Bardreamaster/SuperCapacitor/SuperCapacitor2/References/BOOT配置.png

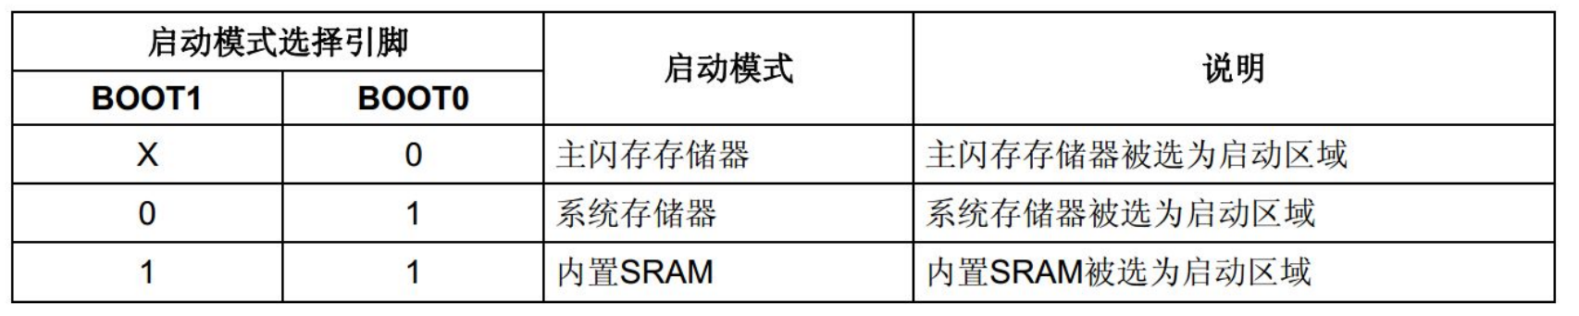
SuperCapacitor2/References/BOOT配置.png
