Bardreamaster/SuperCapacitor/SuperCapacitor2/References/螺丝尺寸.png

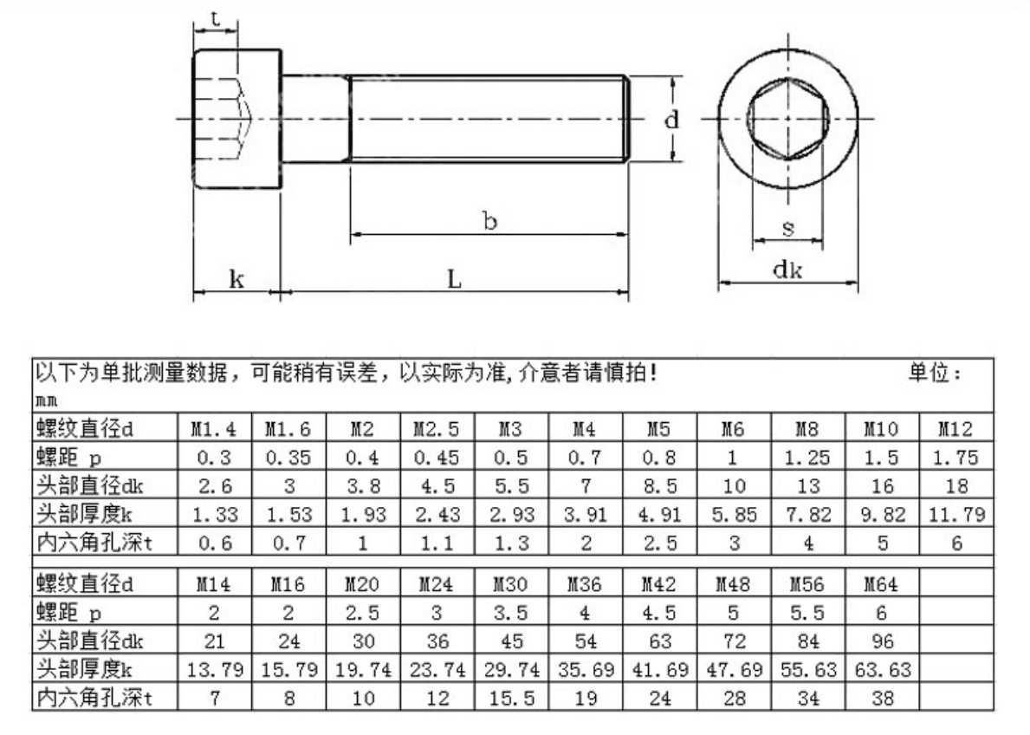
SuperCapacitor2/References/螺丝尺寸.png
