Bardreamaster/SuperCapacitor/SuperCapacitor2/Schematic/CapacitorModule/Capacitor1.0B2.bmp

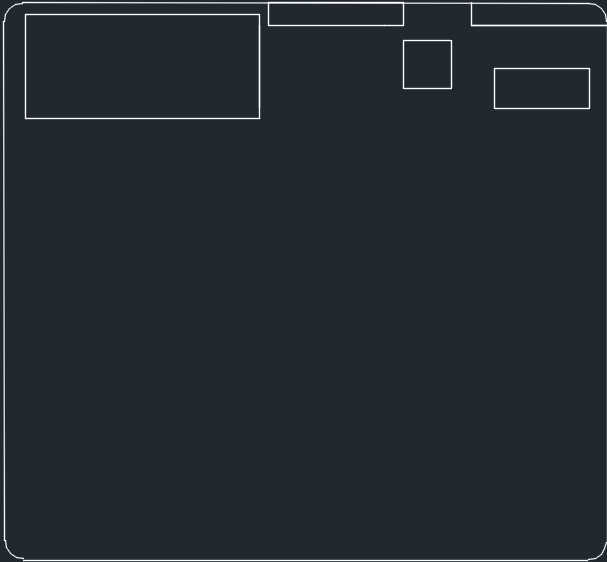
SuperCapacitor2/Schematic/CapacitorModule/Capacitor1.0B2.bmp
