Bardreamaster/SuperCapacitor/SuperCapacitor2/Schematic/CapacitorModule/Capacitor1.0T1.bmp

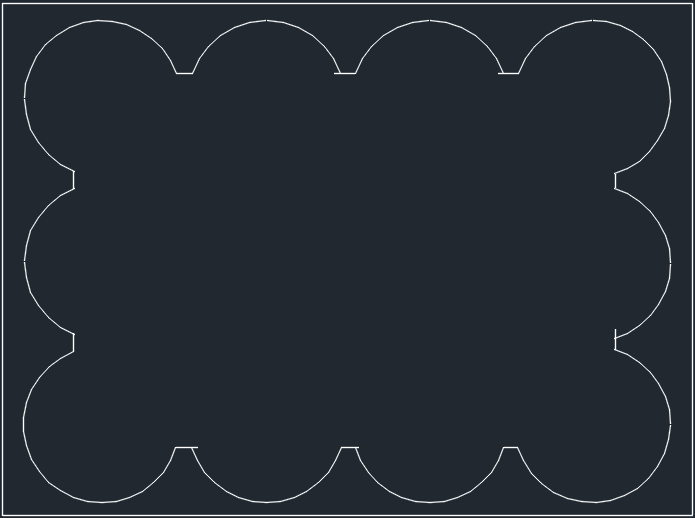
SuperCapacitor2/Schematic/CapacitorModule/Capacitor1.0T1.bmp
