Bardreamaster/SuperCapacitor/SuperCapacitor2/Schematic/EasyEDA_SuperCapacitor2.0_2020-03-19_00-03-40/BOM_Capacitor_2020-05-15_22-47-46.csv

ID | Name | Designator | Footprint | Quantity | Manufacturer Part | Manufacturer | Supplier | Supplier Part | LCSC Assembly
1 | 120uF | C15 | CAP-TH_BD18.0-P7.50-D1.2-FD | 1 | 120uF 450V 18*40 | ValuePro | LCSC | C47856
2 | 2SD1804L-T-TN3-R | Q12,Q11,Q8,Q5,Q2,Q1,Q9,Q4,Q6,Q3,Q10,Q7 | TO-252-2_L6.5-W6.1-P4.58-LS10.0-BR | 12 | 2SD1804L-T-TN3-R | UTC | LCSC | C85224 | Yes
3 | K8-5851E-L1 | SW1 | SW-TH_6P-L5.8-W5.8-P2.00-LS4.5-BL | 1 | K8-5851E-L1 | HRO | LCSC | C111760
4 | ORH-G36G | LED1,LED2,LED3,LED4 | LED0603-R-RD | 4 | ORH-G36G | Orient | LCSC | C205443 | Yes
5 | 82 | C4,C6,C1,C8,C11,C7,C10,C2,C5,C12,C9,C3 | CAP-TH_BD22.0-P10.00-D2.3-FD | 12 | VEC3R0107QG | VINATech | LCSC | C132806
6 | 4.7 | R22,R27,R12,R26,R1,R8,R21,R28,R35,R18,R3,R36,R29,R31,R4,R10,R20,R19,R2,R17,R11,R13,R9,R30 | 0603 | 24 | CR0603FA11R0G | LIZ Elec | LCSC | C100733
7 | 1.3K | R44,R43,R41,R39 | R0402 | 4 | 0402WGF1301TCE | UniOhm | LCSC | C25866 | Yes
8 | 1K | R37,R40,R42,R45,R46,R47 | R0402 | 6 | 0402WGF1001TCE | UniOhm | LCSC | C11702 | Yes
9 | 1K | R16,R7,R23,R6,R33,R14,R15,R34,R5,R25,R24,R32 | 0603 | 12 | RC0603DR-071KL | YAGEO | LCSC | C100050
10 | 1uF | C14,C13 | C0603 | 2 | CL10A105KB8NNNC | SAMSUNG | LCSC | C15849 | Yes
11 | LMSZ5233BT1G | D1 | SOD-123_L2.7-W1.6-LS3.7-RD | 1 | LMSZ5233BT1G | LRC | LCSC | C115277 | Yes
12 | XT60 | XT1 | XT60 BY BUCK | 1 | XT60
13 | HT7027A-1 | U8,U12,U6,U5,U1,U7,U4,U9,U2,U11,U3,U10 | SOT-89 | 12 | HT7027A-1 | HOLTEK | LCSC | C40186 | Yes
14 | LM339D | U13 | SOIC-14_L8.7-W3.9-P1.27-LS6.0-BL | 1 | LM339D | Texas Instruments | LCSC | C350549 | Yes
15 | 3.4K | R38 | R0402 | 1 | 0402WGF3401TCE | UniOhm | LCSC | C4940 | Yes
