Bardreamaster/SuperCapacitor/SuperCapacitor2/Schematic/EasyEDA_SuperCapacitor2.0_2020-03-19_00-03-40/BOM_SuperCapacitor2.0_2020-04-24_17-17-58.csv

ID | Name | Designator | Footprint | Quantity | Manufacturer Part | Manufacturer | Supplier | Supplier Part | LCSC Assembly
1 | BCX56-16,115 | Q12 | SOT-89-3_L4.5-W2.5-P1.50-LS4.2-BR | 1 | BCX56-16,115 | Nexperia | LCSC | C100026 | Yes
2 | 1N4148WS T4 | D8,D9 | SOD-323_L1.8-W1.3-LS2.5-FD | 2 | 1N4148WS T4 | CJ | LCSC | C2128 | Yes
3 | GH1.25-4P-立式贴片 | USART1 | SMD-1.25MM-4P-JST-H4.05 | 1 | BM04B-GHS-TBT(LF)(SN) | JST Sales America | LCSC | C161692
4 | 47uF | C22 | CASE-A_3216 | 1 | CA45-A010K476T | Xiangyee | LCSC | C127069 | Yes
5 | MF-NSMF050-2 | U3,U4 | FUSE-1206 | 2 | MF-NSMF050-2 | BOURNS | LCSC | C75464 | Yes
6 | BZT52C3V3S_C173439 | D5,D7,D6 | SOD-323_L1.8-W1.3-LS2.5-RD | 3 | BZT52C3V3S | (MDD) Jiangsu Yutai Elec | LCSC | C173439 | Yes
7 | 100K | R19,R21,R20 | R0402 | 3 | 0402WGF1003TCE | UniOhm | LCSC | C25741 | Yes
8 | 4.7uF | C29 | C0603 | 1 | CL10A475KO8NNNC | SAMSUNG | LCSC | C19666 | Yes
9 | 100 | R2 | R0402 | 1 | AC0402FR-07100RL | YAGEO | LCSC | C144808
10 | molexP4卧 | CN1 | SMD-10.15X4.8-4P | 1 | 532610471 | MOLEX | LCSC | C127368
11 | 33R | R9 | R0603 | 1
12 | 100k | R8 | R0603 | 1
13 | 10K | R16,R22,R23,R24,R13 | R0402 | 5 | 0402WGF1002TCE | UniOhm | LCSC | C25744 | Yes
14 | 4.7nF | C13 | C0402 | 1 | 0402B472K500NT | FH | LCSC | C1538 | Yes
15 | 40.2K | R1 | R0603 | 1 | 0603WAF4022T5E | UniOhm | LCSC | C12447 | Yes
16 | 220uF | C57,C38,C56,C37 | CAP-SMD_BD10.0-L10.3-W10.3-FD | 4 | DV221M050G105A | CapXon | LCSC | C65217
17 | 10uH | L2,L3 | L0603 | 2 | SDFL2012S100KTF | Sunlord | LCSC | C1046 | Yes
18 | 33pF | C24,C25 | C0603 | 2 | CL05C330JB5NNNC | SAMSUNG | LCSC | C70465
19 | 68K | R6,R7 | R0603 | 2 | 0603WAF6802T5E | UniOhm | LCSC | C23231 | Yes
20 | SC8701QDER | U7,U8 | QFN-32_L4.0-W4.0-P0.4-BL-EP2.6 | 2 | SC8701QDER | Southchip Semicon | LCSC | C252410 | Yes
21 | PSMN1R5-30YLC,115 | Q1 | SOT-669_L4.9-W4.0-P1.27-LS6.0-BR | 1 | PSMN1R5-30YLC,115 | Nexperia | LCSC | C427523
22 | 2.2uH | L4,L5 | IND-SMD_L17.5-W17.0_YXMAC1770 | 2 | YXMAC1770-2R2M-IGP | YUXIN TECH | LCSC | C241452
23 | 100pF | C7 | C0603 | 1 | CGA3E2C0G1H101JT0Y0N | TDK | LCSC | C76709
24 | LP5907MFX-2.5/NOPB | U2 | SOT-23-5_L3.0-W1.7-P0.95-LS2.8-BL | 1 | LP5907MFX-2.5/NOPB | TI | LCSC | C165132 | Yes
25 | SMAJ26CA-13-F | D3 | SMA_L4.4-W2.6-LS5.0-BI | 1 | SMAJ26CA-13-F | DIODES | LCSC | C134976 | Yes
26 | 8MHz | X1 | SMD-5032_2P | 1 | X50328MSD2GC | Yangxing Tech | LCSC | C172361 | Yes
27 | 10nf | C14 | C0603 | 1
28 | 1u | C48,C68,C70,C69,C49,C66 | C0402 | 6
29 | 100nf | C50,C46 | C0402 | 2
30 | 100nf | C36,C35,C34 | C0603 | 3
31 | 47pf | C52,C47 | C0402 | 2 |  |  |  | C1567
32 | 1uf | C51,C71 | C0402 | 2
33 | 47nf | C55,C75 | C0402 | 2
34 | 47pf | C72,C67 | C0402 | 2
35 | 2.2nf | C54,C73 | C0402 | 2
36 | 10nf | C53,C74 | C0402 | 2
37 | 1K | R11,R18 | R0603 | 2 | 0402WGF1001TCE | UniOhm | LCSC | C11702 | Yes
38 | BZX584C9V1 | D4 | SOD-523F_L1.7-W0.9-LS1.7-RD | 1 |  |  | LCSC |  | Yes
39 | LEDB | LEDB1 | LED-0603 | 1 |  | EVERLIGHT | LCSC | C72041 | Yes
40 | LED3V3 | LEDG1 | LED-0603 | 1 | 19-217/GHC-YR1S2/3T | EVERLIGHT | LCSC | C72043 | Yes
41 | 6.04K | RILIM4 | R0402 | 1 | WR04X6041FTL | WTC | LCSC | C168240
42 | BZT52C5V1_C173407 | D1 | SOD-123_L2.7-W1.6-LS3.7-RD | 1 | BZT52C5V1 | (MDD) Jiangsu Yutai Elec | LCSC | C173407 | Yes
43 | SVM860VB_R2_00001 | D2 | TO-277B_3P-L6.1-W4.3-LS7.0-BR | 1 | SVM860VB_R2_00001 | PANJIT International | LCSC | C391734
44 | TJA1051T/3/1J | U6 | SOIC-8_150MIL | 1 | TJA1051T/3/1J | NXP | LCSC | C38695 | Yes
45 | GH1.25-2P-立式贴片 | CAN1 | SMD-1.25MM-2P-JST-H4.05 | 1 | BM02B-GHS-TBT (LF)(SN) | JST Sales America | LCSC | C161690
46 | 100nF | C2 | C0603 | 1 | AC0603KRX7R0BB104 | YAGEO | LCSC | C408909
47 | 1uF | C30 | C0603 | 1 | CL10A105KB8NNNC | SAMSUNG | LCSC | C15849 | Yes
48 | 1k | R41,R29,R31,RDOWN2,R39,RDOWN1 | R0402 | 6
49 | NC/270K/68K/0 | R32,R42 | R0402 | 2
50 | 10K | RILIM3,RILIM2 | R0402 | 2
51 | 4.99k | R45,R33 | R0402 | 2
52 | 0/68K/NC | R34,R46 | R0402 | 2
53 | 20K | RUP2 | R0402 | 1
54 | 1K | RSS2N2 | R0402 | 1 |  |  |  | C319809
55 | 0 | R25,R10,R27,R38,R36,R28,R26,R35,R37 | R0603 | 9
56 | 20.5K | RUP1 | R0402 | 1
57 | 0.01 | RSNS1,RSNS4,RSNS3,RSNS2 | R0805 | 4 |  |  |  | C236284
58 | 1k | RSS1P1,RSS2P2,RSS2N1,RSS1N2,RSS2P1,RSS1P2,RSS1N1 | R0402 | 7 |  |  |  | C319809
59 | 10uF | C59,C58,C60,C44,C45,C65,NO1,C63,C39,C40,C64,C41 | C1206 | 12 | GRM31CR61H106KA12L | MuRata | LCSC | C77092
60 | 10K | RILIM1 | R0402 | 1 |  |  | LCSC | C25744 | Yes
61 | 47pF | C12 | C0402 | 1 | 0402CG470J500NT | FH | LCSC | C1567 | Yes
62 | 22uF | C19,C18,C16,C15,C6,C4,C5,C3 | C0603 | 8 | CL10A226MQ8NRNC | SAMSUNG | LCSC | C59461 | Yes
63 | 120 | R17,R14,R15 | R0402 | 3 | 0402WGF1200TCE | UniOhm | LCSC | C25079 | Yes
64 | 100nF | C28,C21,C32,C26,C31,C27,C33,C1 | C0603 | 8 | CL05B104KO5NNNC | SAMSUNG | LCSC | C1525 | Yes
65 | 100nF | C23 | R0603 | 1 | CL05B104KO5NNNC | SAMSUNG | LCSC | C1525 | Yes
66 | 100nF | C61,C42,C62,C43 | C0603 | 4 | CL10B104JB8NNNC | SAMSUNG | LCSC | C1525 | Yes
67 | 4.7uH | L1 | IND-SMD_L6.0-W6.0 | 1 | SMNR6028-4R7MT | ShunXiang Connaught Elec | LCSC | C266428
68 | 309K | R3 | R0603 | 1 | 0603WAF3093T5E | UniOhm | LCSC | C23001 | Yes
69 | 510 | R12 | R0402 | 1 | 0402WGF5100TCE | UniOhm | LCSC | C25123 | Yes
70 | XT30UF | XT3,XT2 | CONN-TH_XT30UPB-F | 2 | XT60
71 | XT30UM | XT1 | CONN-TH_XT30UPB-F | 1 | XT60
72 | HD70N08 | Q6,Q5,Q11,Q7,Q8,Q9,Q10 | PDFN-8_L4.9-W5.8-P1.27-LS6.1-BL FOR3 | 7 | HD70N08 | HL | LCSC | C216254
73 | HD70N08 | Q4 | PDFN-8_L4.9-W5.8-P1.27-LS6.1-BL FOR3 | 1 | HD70N08 | HL | LCSC | C190849
74 | SKRPABE010 | SW2,SW1 | KEY-SMD-4P_L4.2-W3.2-H2.5 | 2 | SKRPABE010 | ALPS | LCSC | C115360
75 | 7.68K | R4 | R0402 | 1 | 0402WGF7681TCE | UniOhm | LCSC | C25919 | Yes
76 | 100nF | C17 | C0402 | 1 | GRM188R71H104KA93D | MuRata | LCSC | C77055
77 | 17.8K | R5 | R0603 | 1 | 0603WAF1782T5E | UniOhm | LCSC | C22821 | Yes
78 | TPS54540DDAR | U1 | SOIC-8_L4.9-W3.9-P1.27-LS6.0-BL-EP | 1 | TPS54540DDAR | TI | LCSC | C95286 | Yes
79 | 4.7uF | C11,C10,C9,C8 | C0805 | 4 | CL21A475KBQNNNE | SAMSUNG | LCSC | C98192
80 | A2008WV-S-2P | CN4 | CONN-SMD_A2008WV-S-2P | 1 | A2008WV-S-2P | Changjiang Connectors | LCSC | C273123
81 | STM32F103C8T6 | U5 | LQFP-48_7X7X05P | 1 | STM32F103C8T6 | ST | LCSC | C8734
