Bardreamaster/SuperCapacitor/SuperCapacitor2/Schematic/3DModel/SCapacitor2.0.SLDPRT

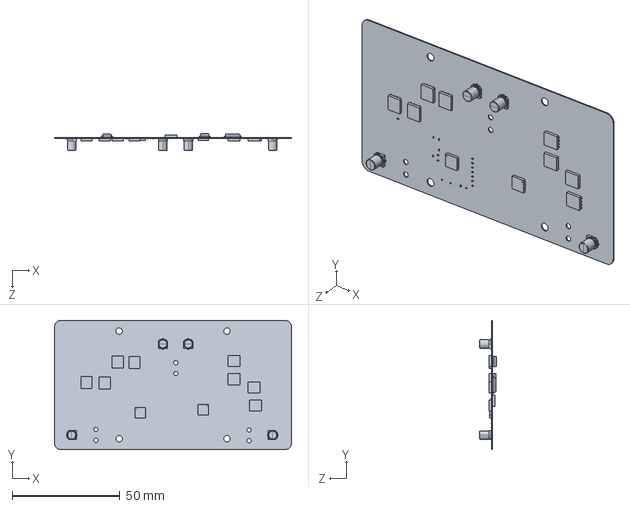
[picture p11: CAD file, 2021-09-17]
SuperCapacitor2/Schematic/3DModel/SCapacitor2.0.SLDPRT
110.0 x 60.0 x 7.66 mm
