Bardreamaster/SuperCapacitor/SuperCapacitor2/Schematic/CapacitorModule/Capacitor1.0_2020-07-27_20-29-36.dxf

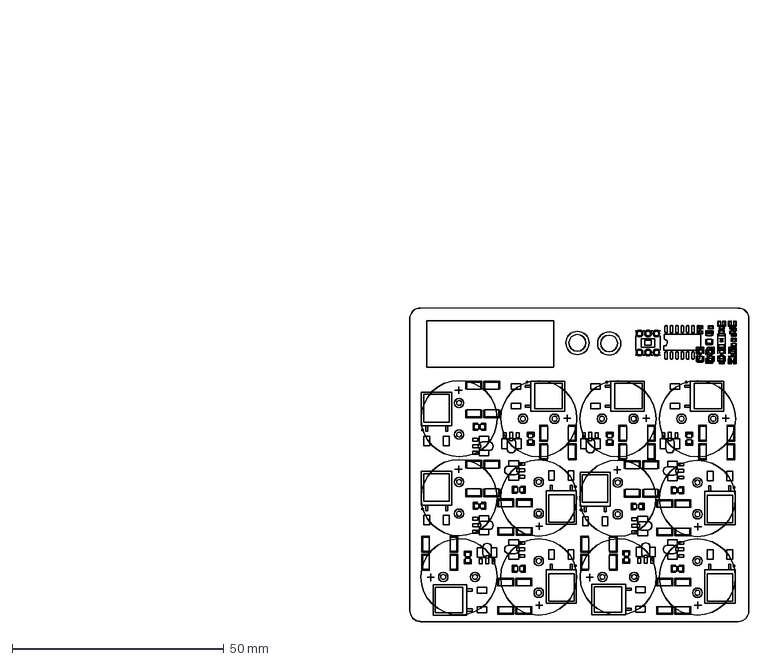
[picture p12: CAD file, 2021-09-17]
SuperCapacitor2/Schematic/CapacitorModule/Capacitor1.0_2020-07-27_20-29-36.dxf
173.1 x 142.9 mm
