Bardreamaster/SuperCapacitor/SuperCapacitorSC1/SC1.0.SLDPRT

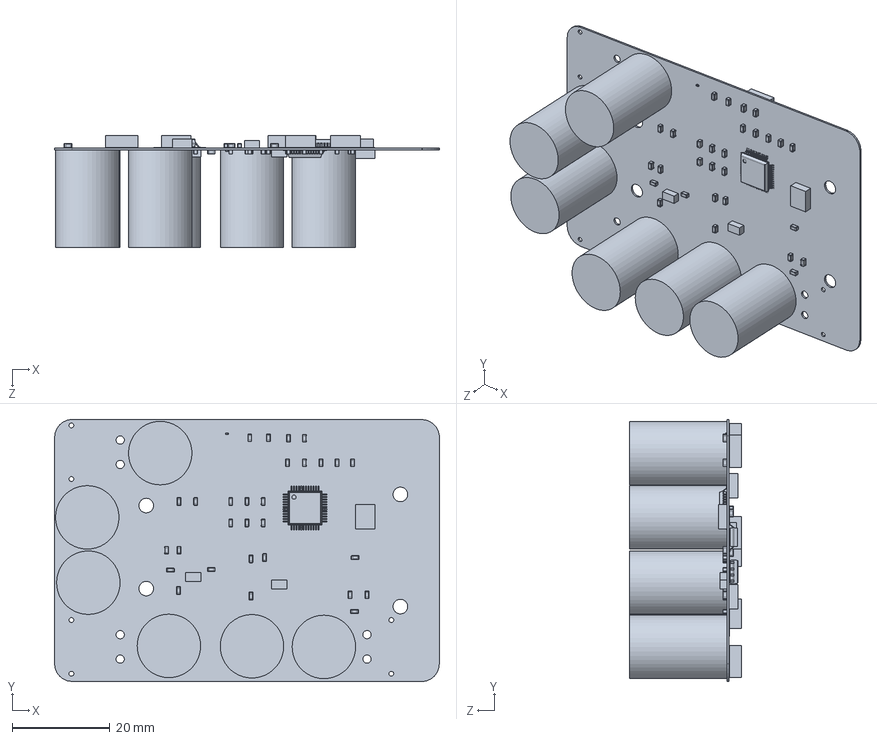
[picture p13: CAD file, 2021-09-17]
SuperCapacitorSC1/SC1.0.SLDPRT
78.9 x 53.7 x 22.9 mm
