Bardreamaster/SuperCapacitor/SuperCapacitor2/Schematic/3DModel/6010风扇外框.SLDPRT

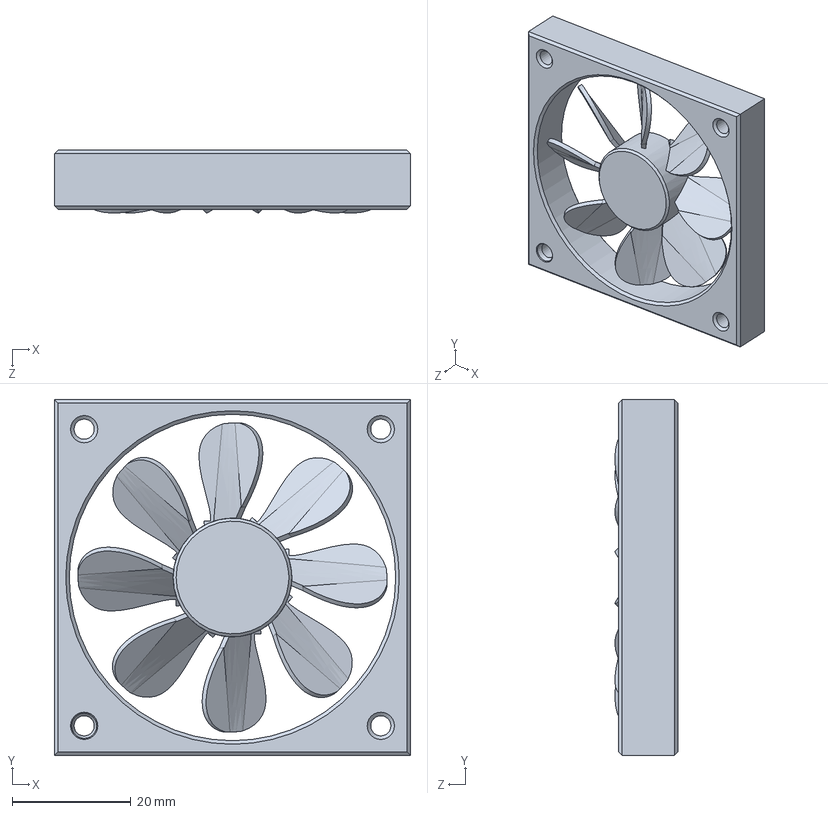
[picture p14: CAD file, 2021-09-17]
SuperCapacitor2/Schematic/3DModel/6010风扇外框.SLDPRT
60.0 x 60.0 x 10.6 mm
