Bardreamaster/SuperCapacitor/SuperCapacitor2/Schematic/CapacitorModule/Capacitor1.0T1.dxf

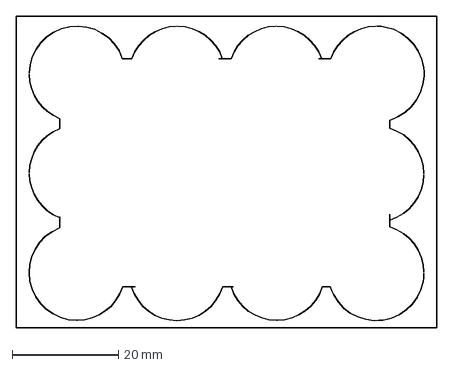
[picture p15: CAD file, 2021-09-17]
SuperCapacitor2/Schematic/CapacitorModule/Capacitor1.0T1.dxf
79.2 x 58.7 mm
