Bardreamaster/SuperCapacitor/SuperCapacitor2/Schematic/CapacitorModule/Capacitor1.0B1.dxf

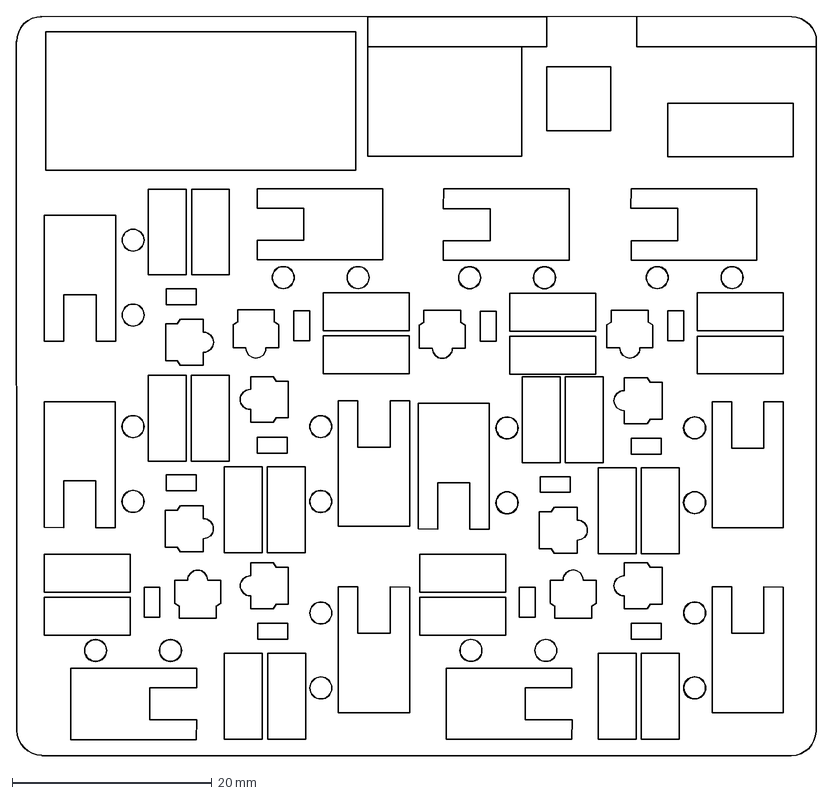
[picture p16: CAD file, 2021-09-17]
SuperCapacitor2/Schematic/CapacitorModule/Capacitor1.0B1.dxf
80.1 x 74.0 mm
