Bardreamaster/SuperCapacitor/SuperCapacitor2/Schematic/CapacitorModule/SC2.SLDPRT

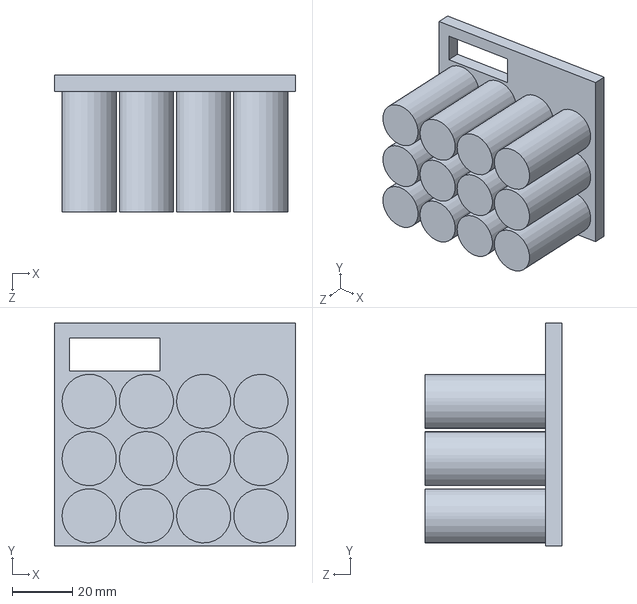
[picture p17: CAD file, 2021-09-17]
SuperCapacitor2/Schematic/CapacitorModule/SC2.SLDPRT
80.0 x 74.0 x 45.6 mm
