Bardreamaster/SuperCapacitor/SuperCapacitor2/Schematic/CapacitorModule/Capacitor1.0B2.dxf

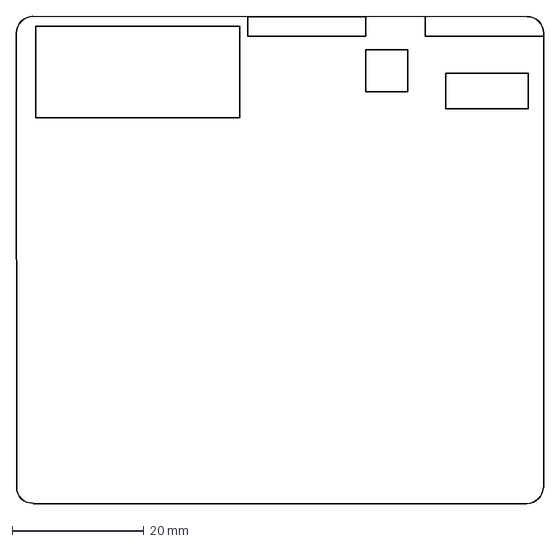
[picture p18: CAD file, 2021-09-17]
SuperCapacitor2/Schematic/CapacitorModule/Capacitor1.0B2.dxf
80.1 x 74.0 mm
