Bardreamaster/SuperCapacitor/SuperCapacitor2/DeveloperGuide/SC2.0F103.png

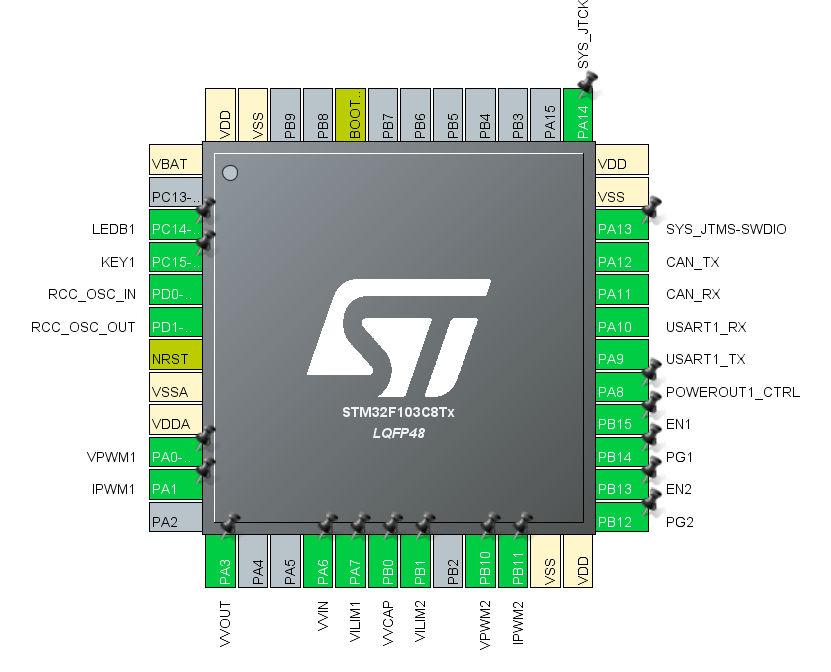
SuperCapacitor2/DeveloperGuide/SC2.0F103.png
