Bardreamaster/SuperCapacitor/(list of files, drawings)

Other design files:
SuperCapacitor2/Schematic/AD18_SuperCapacitor2.0_2020-03-19_00-03-40/MCU copy.SchDoc
SuperCapacitor2/Schematic/AD18_SuperCapacitor2.0_2020-03-19_00-03-40/power copy.SchDoc
SuperCapacitor2/Schematic/AD18_SuperCapacitor2.0_2020-03-19_00-03-40/SC2.0.PrjPCB
SuperCapacitor2/Schematic/AD18_SuperCapacitor2.0_2020-03-19_00-03-40/SCapacitor2.0_2020-03-19_00-03-24.pcbdoc
SuperCapacitor2/Schematic/AD18_SuperCapacitor2.0_2020-03-19_00-03-40/Switch1 copy.SchDoc
SuperCapacitor2/Schematic/AD18_SuperCapacitor2.0_2020-03-19_00-03-40/Switch2 copy.SchDoc
SuperCapacitor2/Schematic/CapacitorModule/Capacitor1.0PCB.pcbdoc
SuperCapacitor2/Schematic/CapacitorModule/电压指示灯.ms14
SuperCapacitor2/Schematic/EasyEDA_SuperCapacitor2.0_2020-03-19_00-03-40/SCapacitor2.0_2020-03-19_00-01-07.json
SuperCapacitor2/Schematic/EasyEDA_SuperCapacitor2.0_2020-03-19_00-03-40/SCapacitor2.0_2020-05-15_16-26-46.json
SuperCapacitor2/Schematic/EasyEDA_SuperCapacitor2.0_2020-03-19_00-03-40/SuperCapacitor2.0_2020-03-19_00-01-51.json
SuperCapacitor2/Schematic/EasyEDA_SuperCapacitor2.0_2020-03-19_00-03-40/SuperCapacitor2.0_2020-05-15_16-26-28.json
SuperCapacitorSC1/原理图/F103.SchDoc
SuperCapacitorSC1/原理图/PCB_Project1.PrjPCB
SuperCapacitorSC1/原理图/SC1.0.pcbdoc
SuperCapacitorSC1/原理图/SWITCH.SchDoc
