Bardreamaster/SuperCapacitor/SuperCapacitorSC1/code/USER/Hardware/adc/adc.c

#include "main.h"
#include "adc.h"
#include "stm32f10x.h"

void adc_init(void)
{
		ADC_InitTypeDef ADC_InitStructure; 
		GPIO_InitTypeDef GPIO_InitStructure;

        
		RCC_APB2PeriphClockCmd(RCC_APB2Periph_GPIOB |RCC_APB2Periph_GPIOA |RCC_APB2Periph_ADC1, ENABLE );	  //使能ADC1通道时钟
 
		RCC_ADCCLKConfig(RCC_PCLK2_Div6);   //设置ADC分频因子6 72M/6=12,ADC最大时间不能超过14M
	
        //ADC1 CH8 PB0 电池输出
		GPIO_InitStructure.GPIO_Pin = GPIO_Pin_0;
		GPIO_InitStructure.GPIO_Mode = GPIO_Mode_AIN;		//模拟输入引脚
		GPIO_Init(GPIOB, &GPIO_InitStructure);
    
        //ADC1 CH5 PA5 负载电压
        GPIO_InitStructure.GPIO_Pin = GPIO_Pin_5;
		GPIO_InitStructure.GPIO_Mode = GPIO_Mode_AIN;		//模拟输入引脚
		GPIO_Init(GPIOA, &GPIO_InitStructure);
    
        //ADC1 CH6 PA6 输入电源电压
        GPIO_InitStructure.GPIO_Pin = GPIO_Pin_6;
		GPIO_InitStructure.GPIO_Mode = GPIO_Mode_AIN;		//模拟输入引脚
		GPIO_Init(GPIOA, &GPIO_InitStructure);

	    //ADC1 CH7 PA7 超级电容电压
        GPIO_InitStructure.GPIO_Pin = GPIO_Pin_7;
		GPIO_InitStructure.GPIO_Mode = GPIO_Mode_AIN;		//模拟输入引脚
		GPIO_Init(GPIOA, &GPIO_InitStructure);

		ADC_DeInit(ADC1);  //复位ADC1,将外设 ADC1 的全部寄存器重设为缺省值

		ADC_InitStructure.ADC_Mode = ADC_Mode_Independent;	//ADC工作模式:ADC1和ADC2工作在独立模式
		ADC_InitStructure.ADC_ScanConvMode = DISABLE;	//模数转换工作在单通道模式
		ADC_InitStructure.ADC_ContinuousConvMode = DISABLE;	//模数转换工作在单次转换模式
		ADC_InitStructure.ADC_ExternalTrigConv = ADC_ExternalTrigConv_None;	//转换由软件而不是外部触发启动
		ADC_InitStructure.ADC_DataAlign = ADC_DataAlign_Right;	//ADC数据右对齐
		ADC_InitStructure.ADC_NbrOfChannel = 1;	//顺序进行规则转换的ADC通道的数目
		ADC_Init(ADC1, &ADC_InitStructure);	//根据ADC_InitStruct中指定的参数初始化外设ADCx的寄存器  
	
		ADC_Cmd(ADC1, ENABLE);	//使能指定的ADC1
	
		ADC_ResetCalibration(ADC1);	//使能复位校准  
	 
		while(ADC_GetResetCalibrationStatus(ADC1));	//等待复位校准结束
	
		ADC_StartCalibration(ADC1);	 //开启AD校准
 
		while(ADC_GetCalibrationStatus(ADC1));
		
		ADC_RegularChannelConfig(ADC1, ADC_Channel_8, 1, ADC_SampleTime_239Cycles5 );	//ADC1,ADC通道,采样时间为239.5周期	  
		ADC_RegularChannelConfig(ADC1, ADC_Channel_5, 1, ADC_SampleTime_239Cycles5 );	//ADC1,ADC通道,采样时间为239.5周期	  
		ADC_RegularChannelConfig(ADC1, ADC_Channel_6, 1, ADC_SampleTime_239Cycles5 );	//ADC1,ADC通道,采样时间为239.5周期	  
		ADC_RegularChannelConfig(ADC1, ADC_Channel_7, 1, ADC_SampleTime_239Cycles5 );	//ADC1,ADC通道,采样时间为239.5周期	  

        //ADC2 PB1 底盘输出
    RCC_APB2PeriphClockCmd(RCC_APB2Periph_GPIOB |RCC_APB2Periph_ADC2, ENABLE );	  //使能ADC2通道时钟
    RCC_ADCCLKConfig(RCC_PCLK2_Div6);   //设置ADC分频因子6 72M/6=12,ADC最大时间不能超过14
				
		GPIO_InitStructure.GPIO_Pin = GPIO_Pin_1;
		GPIO_InitStructure.GPIO_Mode = GPIO_Mode_AIN;		//模拟输入引脚
		GPIO_Init(GPIOB, &GPIO_InitStructure);
	
		ADC_DeInit(ADC2);  //复位ADC1,将外设 ADC1 的全部寄存器重设为缺省值

		ADC_InitStructure.ADC_Mode = ADC_Mode_Independent;	//ADC工作模式:ADC1和ADC2工作在独立模式
		ADC_InitStructure.ADC_ScanConvMode = DISABLE;	//模数转换工作在单通道模式
		ADC_InitStructure.ADC_ContinuousConvMode = DISABLE;	//模数转换工作在单次转换模式
		ADC_InitStructure.ADC_ExternalTrigConv = ADC_ExternalTrigConv_None;	//转换由软件而不是外部触发启动
		ADC_InitStructure.ADC_DataAlign = ADC_DataAlign_Right;	//ADC数据右对齐
		ADC_InitStructure.ADC_NbrOfChannel = 1;	//顺序进行规则转换的ADC通道的数目
		ADC_Init(ADC2, &ADC_InitStructure);	//根据ADC_InitStruct中指定的参数初始化外设ADCx的寄存器  
	
		ADC_Cmd(ADC2, ENABLE);	//使能指定的ADC1
	
		ADC_ResetCalibration(ADC2);	//使能复位校准  
	 
		while(ADC_GetResetCalibrationStatus(ADC2));	//等待复位校准结束
	
		ADC_StartCalibration(ADC2);	 //开启AD校准
 
		while(ADC_GetCalibrationStatus(ADC2));
		
		ADC_RegularChannelConfig(ADC2, ADC_Channel_9, 1, ADC_SampleTime_239Cycles5 );	//ADC2,ADC通道,采样时间为239.5周期

}

fp32 get_i_in(void)
{
    ADC_RegularChannelConfig(ADC1, ADC_Channel_8, 1, ADC_SampleTime_239Cycles5 );
    ADC_SoftwareStartConvCmd(ADC1, ENABLE);
    while(!ADC_GetFlagStatus(ADC1, ADC_FLAG_EOC));

    return (ADC_GetConversionValue(ADC1) * adc_to_v - v_to_i_b) / v_to_i_k;
}

fp32 get_i_load(void)
{
    ADC_RegularChannelConfig(ADC2, ADC_Channel_9, 1, ADC_SampleTime_239Cycles5 );
    ADC_SoftwareStartConvCmd(ADC2, ENABLE);
    while(!ADC_GetFlagStatus(ADC2, ADC_FLAG_EOC));
    
    return (ADC_GetConversionValue(ADC1) * adc_to_v - v_to_i_b) / v_to_i_k;
}

fp32 get_v_load(void)
{
    ADC_RegularChannelConfig(ADC1, ADC_Channel_5, 1, ADC_SampleTime_239Cycles5 );
    ADC_SoftwareStartConvCmd(ADC1, ENABLE);
    while(!ADC_GetFlagStatus(ADC1, ADC_FLAG_EOC));
    return ADC_GetConversionValue(ADC1) * adc_to_v * 11;
}

fp32 get_v_in(void)
{
    ADC_RegularChannelConfig(ADC1, ADC_Channel_6, 1, ADC_SampleTime_239Cycles5 );
    ADC_SoftwareStartConvCmd(ADC1, ENABLE);
    while(!ADC_GetFlagStatus(ADC1, ADC_FLAG_EOC));
    return ADC_GetConversionValue(ADC1) * adc_to_v * 11;
}
fp32 get_v_cap(void)
{
    ADC_RegularChannelConfig(ADC1, ADC_Channel_7, 1, ADC_SampleTime_239Cycles5 );
    ADC_SoftwareStartConvCmd(ADC1, ENABLE);
    while(!ADC_GetFlagStatus(ADC1, ADC_FLAG_EOC));
    return ADC_GetConversionValue(ADC1) * adc_to_v * 11;
}
