Bardreamaster/SuperCapacitor/SuperCapacitorSC1/code/USER/Hardware/usart/usart.c

#include "main.h"
#include "usart.h"
#include "stm32f10x.h"

void usart_init(void)
{
		USART_InitTypeDef USART_InitStructure;
		GPIO_InitTypeDef GPIO_InitStructure;
        NVIC_InitTypeDef NVIC_InitStructure;

		RCC_APB2PeriphClockCmd(RCC_APB2Periph_USART1,ENABLE);
		RCC_APB2PeriphClockCmd(RCC_APB2Periph_GPIOA,ENABLE);
	
        //TX
		GPIO_InitStructure.GPIO_Pin = GPIO_Pin_9; //PA.9
		GPIO_InitStructure.GPIO_Speed = GPIO_Speed_50MHz;
		GPIO_InitStructure.GPIO_Mode = GPIO_Mode_AF_PP;	//复用推挽输出
		GPIO_Init(GPIOA, &GPIO_InitStructure);//初始化GPIOA.9
    
        //RX
		GPIO_InitStructure.GPIO_Pin = GPIO_Pin_10;//PA10
		GPIO_InitStructure.GPIO_Mode = GPIO_Mode_IN_FLOATING;//浮空输入
		GPIO_Init(GPIOA, &GPIO_InitStructure);//初始化GPIOA.10  
	
        NVIC_InitStructure.NVIC_IRQChannel = USART1_IRQn;
        NVIC_InitStructure.NVIC_IRQChannelPreemptionPriority=1;//抢占优先级1
        NVIC_InitStructure.NVIC_IRQChannelSubPriority = 1;		//子优先级1
        NVIC_InitStructure.NVIC_IRQChannelCmd = ENABLE;			//IRQ通道使能
        NVIC_Init(&NVIC_InitStructure);	//根据指定的参数初始化VIC寄存器
    
		USART_InitStructure.USART_BaudRate = 115200;//串口波特率
		USART_InitStructure.USART_WordLength = USART_WordLength_8b;//字长为8位数据格式
		USART_InitStructure.USART_StopBits = USART_StopBits_1;//一个停止位
		USART_InitStructure.USART_Parity = USART_Parity_No;//无奇偶校验位
		USART_InitStructure.USART_HardwareFlowControl = USART_HardwareFlowControl_None;//无硬件数据流控制
		USART_InitStructure.USART_Mode = USART_Mode_Rx | USART_Mode_Tx;	//收发模式

		USART_Init(USART1, &USART_InitStructure); //初始化串口1
        USART_ITConfig(USART1, USART_IT_RXNE, ENABLE);//开启串口接受中断
		USART_Cmd(USART1, ENABLE);
}

void USART1_IRQHandler(void)
{
	uint8_t Res;
	if(USART_GetITStatus(USART1, USART_IT_RXNE) != RESET)  //接收中断(接收到的数据必须是0x0d 0x0a结尾)
	{
		Res = USART_ReceiveData(USART1);	//读取接收到的数据
    }
}
