Bardreamaster/SuperCapacitor/SuperCapacitorSC1/code/USER/Main/main.h

#ifndef MAIN_H
#define MAIN_H

typedef signed char int8_t;
typedef signed short int int16_t;
typedef signed int int32_t;
typedef signed long long int64_t;

typedef unsigned char uint8_t;
typedef unsigned short int uint16_t;
typedef unsigned int uint32_t;
typedef unsigned long long uint64_t;
typedef unsigned char bool_t;
typedef float fp32;
typedef double fp64;

int main(void);
void peripheral_init(void);

#endif
